Lakshay983/TrialWorkday-PCB/BPS-Amperes.kicad_sch

## KiCad design BPS-Amperes.kicad_sch (2024-09-21)

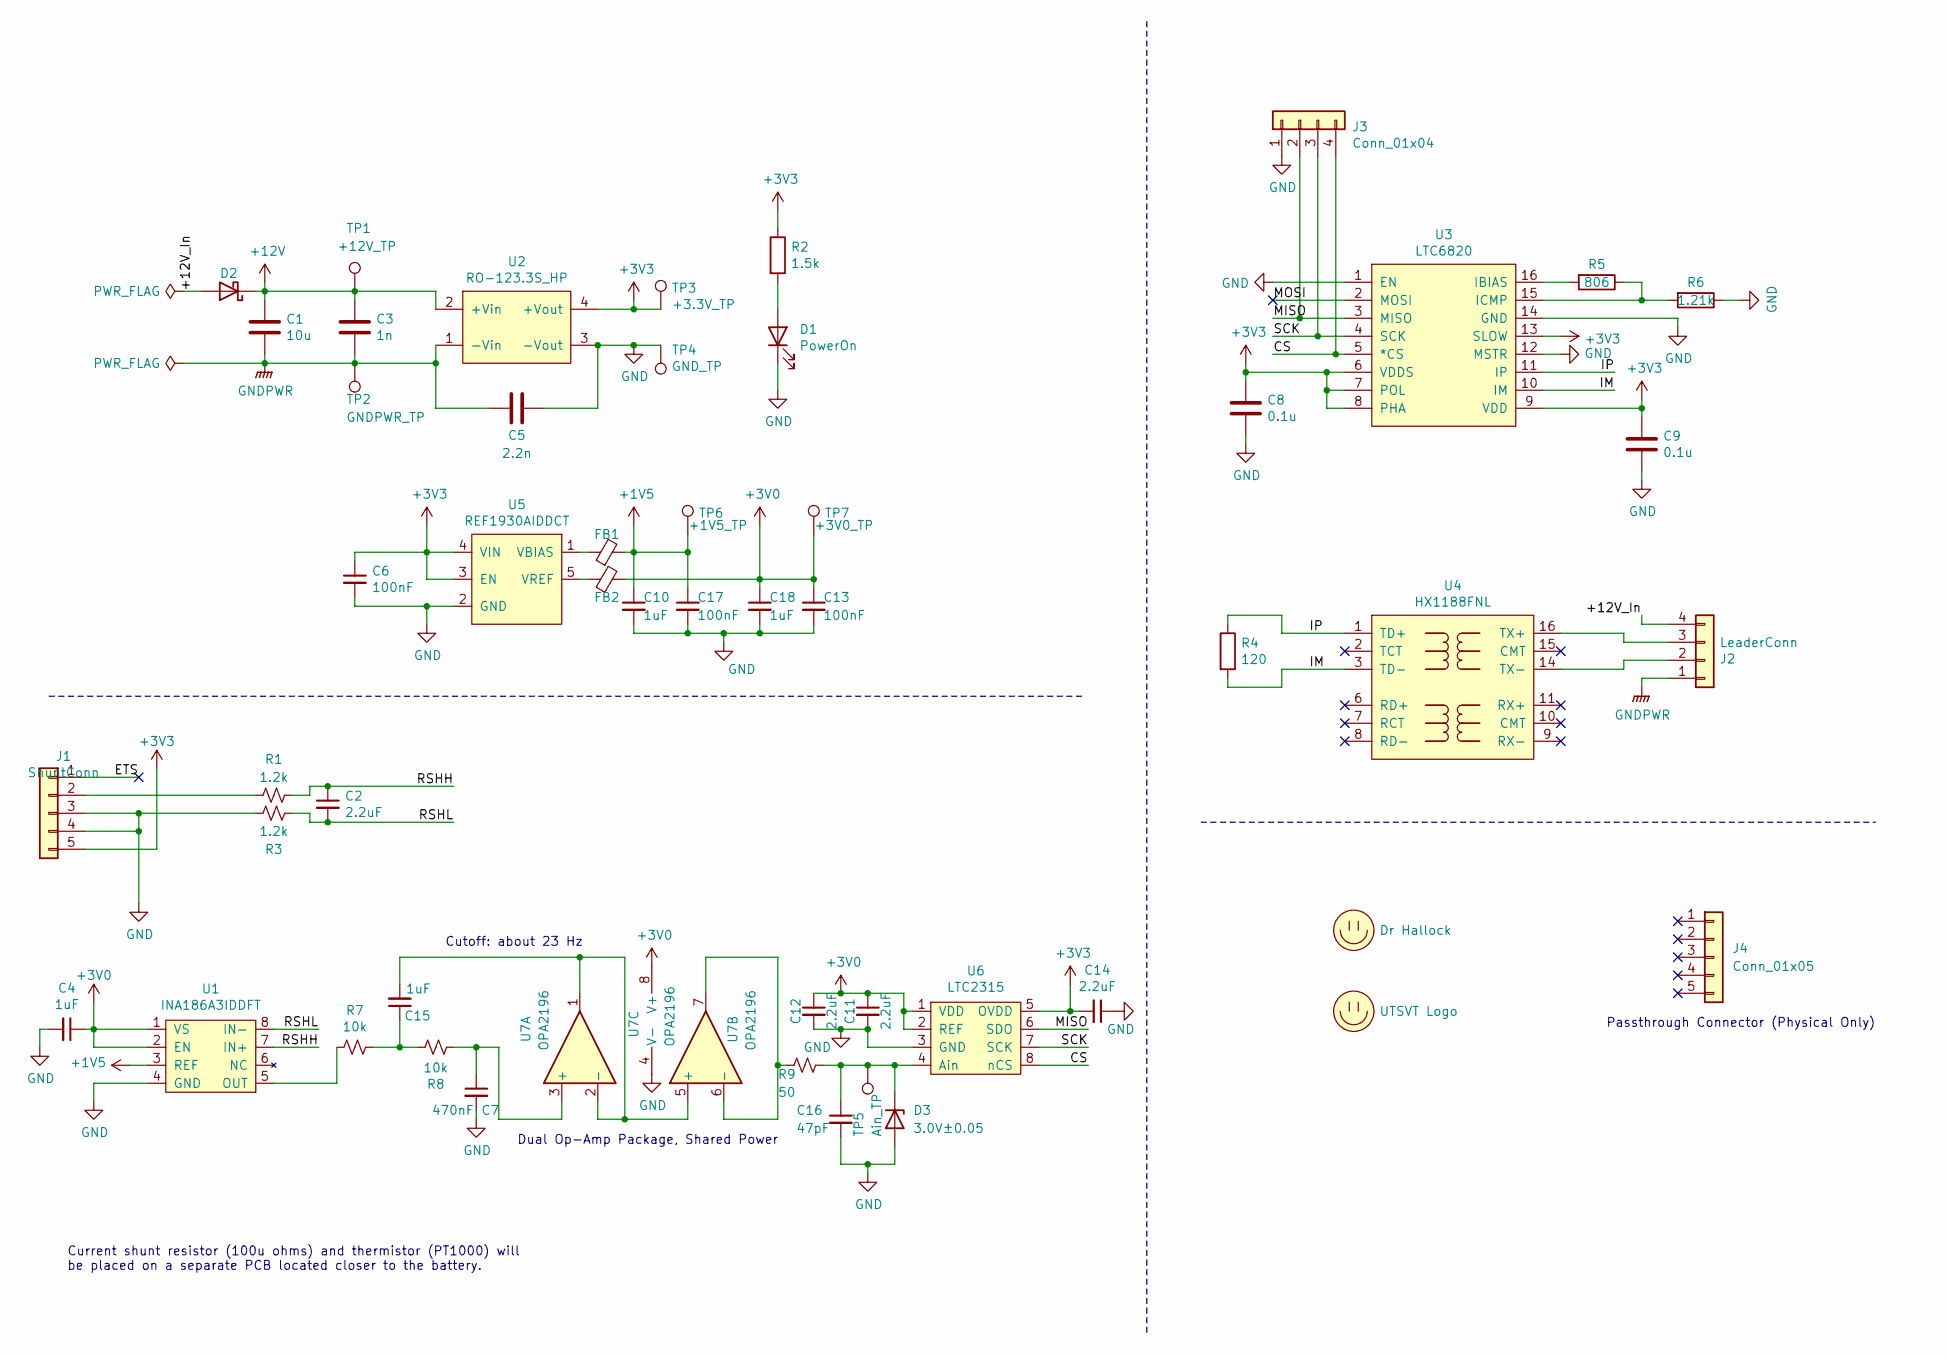
[picture p1: schematic BPS-Amperes.kicad_sch]

Parts:
C1: 10u; C_2220_5750Metrix
C2, C11, C12, C14: 2.2uF; C_0805_2012Metric
C3: 1n; C_0805_2012Metric
C4, C10, C15, C18: 1uF; C_0805_2012Metric
C5: 2.2n; C_0805_2012Metric
C6, C13, C17: 100nF; C_0805_2012Metric
C7: 470nF; C_0805_2012Metric
C8, C9: 0.1u; C_0805_2012Metric
C16: 47pF; C_0805_2012Metric
D1: PowerOn; LED_0805_2012Metric
D2: D_Schottky; D_0805_2012Metric
D3: 3.0V±0.05; D_0805_2012Metric
FB1, FB2: FerriteBead_Small; L_0805_2012Metric
J1: ShuntConn; PinSocket_1x05_P2.54mm_Vertical
J2: LeaderConn; Molex_Micro-Fit_3.0_43650-0415_1x04_P3.00mm_Vertical
J3: Conn_01x04; PinHeader_1x04_P2.54mm_Vertical
J4: Conn_01x05; PinHeader_1x05_P2.54mm_Vertical
LOGO1: Dr Hallock; Hallock_Image_Tiny
LOGO2: UTSVT Logo; UTSVT_Logo_Symbol
R1, R3: 1.2k; R_0805_2012Metric
R2: 1.5k; R_0805_2012Metric
R4: 120; R_0805_2012Metric
R5: 806; R_0805_2012Metric
R6: 1.21k; R_0805_2012Metric
R7, R8: 10k; R_0805_2012Metric
R9: 50; R_0805_2012Metric
TP1: +12V_TP; TestPoint_Pad_2.0x2.0mm
TP2: GNDPWR_TP; TestPoint_Pad_2.0x2.0mm
TP3: +3.3V_TP; TestPoint_Pad_1.5x1.5mm
TP4: GND_TP; TestPoint_Pad_1.5x1.5mm
TP5: Ain_TP; PinSocket_1x01_P2.54mm_Vertical
TP6: +1V5_TP; TestPoint_Pad_1.5x1.5mm
TP7: +3V0_TP; TestPoint_Pad_1.5x1.5mm
U1: INA186A3IDDFT; SOT-23-8
U2: RO-123.3S_HP; RI3_DC_Converter
U3: LTC6820; MSOP-16_3x4mm_P0.5mm
U4: HX1188FNL; HXXXX
U5: REF1930AIDDCT; SOT-23-5
U6: LTC2315; SOT-23-8
U7: OPA2196; SOIC-8_3.9x4.9mm_P1.27mm

Connections:
+1V5: C10.1, C17.1, FB1.2, TP6.1, U1.3 (REF)
+3V0: C4.1, C11.1, C12.1, C13.1, C18.1, FB2.2, TP7.1, U1.1 (VS), U1.2 (EN), U6.1 (VDD), U6.2 (REF), U7.8 (V+)
+3V3: C6.1, C8.1, C9.1, C14.2, J1.5, R2.1, TP3.1, U2.4 (+Vout), U3.6 (VDDS), U3.7 (POL), U3.8 (PHA), U3.9 (VDD), U3.13 (SLOW), U5.3 (EN), U5.4 (VIN), U6.5 (OVDD)
+12V: C1.1, C3.1, D2.1 (K), TP1.1, U2.2 (+Vin)
+12V_In: D2.2 (A), J2.4
CS: J3.4, U3.5 (*CS), U6.8 (nCS)
ETS: J1.1
GND: C4.2, C5.2, C6.2, C7.2, C8.2, C9.2, C10.2, C11.2, C12.2, C13.2, C14.1, C16.2, C17.2, C18.2, D1.1 (K), D3.2 (A), J1.3, J1.4, J3.1, R3.2, R6.1, TP4.1, U1.4 (GND), U2.3 (-Vout), U3.1 (EN), U3.12 (MSTR), U3.14 (GND), U5.2 (GND), U6.3 (GND), U7.4 (V-)
GNDPWR: C1.2, C3.2, C5.1, J2.1, TP2.1, U2.1 (-Vin)
IM: R4.2, U3.10 (IM), U4.3 (TD-)
IP: R4.1, U3.11 (IP), U4.1 (TD+)
MISO: J3.2, U3.3 (MISO), U6.6 (SDO)
MOSI: U3.2 (MOSI)
unnamed: C7.1, R8.2, U7.3 (+)
unnamed: C15.1, R7.1, R8.1
unnamed: C15.2, U7.1, U7.2 (-), U7.5 (+)
unnamed: C16.1, D3.1 (K), R9.2, TP5.1, U6.4 (Ain)
unnamed: D1.2 (A), R2.2
unnamed: FB1.1, U5.1 (VBIAS)
unnamed: FB2.1, U5.5 (VREF)
unnamed: J1.2, R1.2
unnamed: J2.2, U4.14 (TX-)
unnamed: J2.3, U4.16 (TX+)
unnamed: R5.1, R6.2, U3.15 (ICMP)
unnamed: R5.2, U3.16 (IBIAS)
unnamed: R7.2, U1.5 (OUT)
unnamed: R9.1, U7.6 (-), U7.7
RSHH: C2.1, R1.1, U1.7 (IN+)
RSHL: C2.2, R3.1, U1.8 (IN-)
SCK: J3.3, U3.4 (SCK), U6.7 (SCK)

Notes on the sheet:
Current shunt resistor (100u ohms) and thermistor (PT1000) will be placed on a separate PCB located closer to the battery.
Cutoff: about 23 Hz
Passthrough Connector (Physical Only)
Dual Op-Amp Package, Shared Power
