Lakshay983/TrialWorkday-PCB/(commit log)

2021-08-29 fix merge conflict
    [BPS-Amperes.kicad_pcb]
2021-10-01 Replace AS8510 with AD8417+ADS7042
    [BPS-Amperes.kicad_pcb, BPS-Amperes.sch]
2021-10-02 Set up for new amplification scheme
    [BPS-Amperes.kicad_pcb, BPS-Amperes.sch]
2021-11-06 Revised with LTC ADC
    [BPS-Amperes.kicad_pcb, BPS-Amperes.sch]
2021-12-22 Add additional filtering
    [BPS-Amperes.kicad_pcb, BPS-Amperes.sch]
2021-12-24 Add voltage follower before ADC
    [BPS-Amperes.kicad_pcb, BPS-Amperes.sch]
2021-12-25 Space out components
    [BPS-Amperes.kicad_pcb]
2021-12-25 Minor change to capacitor value
    [BPS-Amperes.sch]
2021-12-25 Flip logo
    [BPS-Amperes.kicad_pcb]
2022-01-15 Update to what should be the final version
    [Amperes.step, BPS-Amperes.kicad_pcb, BPS-Amperes.kicad_sch, BPS-Amperes.sch]
2022-01-15 Minor fixing
    [BPS-Amperes.kicad_pcb, BPS-Amperes.kicad_sch]
2022-01-22 Update label
    [BPS-Amperes.kicad_pcb]
2022-09-24 emi + reverse polarity + analog overvolt protection
    [BPS-Amperes.kicad_sch]
2022-09-24 hat connector
    [BPS-Amperes.kicad_sch]
2022-10-08 more bypass caps and other fixes
    [BPS-Amperes.kicad_sch]
2022-10-08 make a little easier on the eyes
    [BPS-Amperes.kicad_sch]
2022-10-08 datasheets & annotations
    [BPS-Amperes.kicad_sch]
2022-10-08 shunt connector change
    [BPS-Amperes.kicad_sch]
2022-10-08 bom💣
    [BPS-Amperes.xlsx]
2022-10-09 mouser 🐁 bom 💣 cart 🛒
    [BPS-Amperes.csv, BPS-Amperes.kicad_sch, BPS-Amperes.xlsx]
2022-10-29 layout with no pours
    [BPS-Amperes.kicad_pcb, BPS-Amperes.kicad_sch]
2022-10-29 add 👈 pass 💦 through 🐲 connector
    and move 📦 things 🍄 around ➕🏜️➡️👤 a bit 😁
    [BPS-Amperes.kicad_pcb, BPS-Amperes.kicad_sch]
2022-10-31 tighten ground pour
    [BPS-Amperes.kicad_pcb]
2022-11-05 picket fence
    [BPS-Amperes.kicad_pcb, BPS-Amperes.kicad_sch]
2022-11-05 Fixed silkscreens
2022-11-15 Added silkscreens
    [BPS-Amperes.kicad_pcb]
2022-11-19 gerbers 🐹 and drills 🪛
    [BPS-Amperes-B_Cu.gbr, BPS-Amperes-B_Mask.gbr, BPS-Amperes-B_Paste.gbr, BPS-Amperes-B_Silkscreen.gbr, BPS-Amperes-Edge_Cuts.gbr, BPS-Amperes-F_Cu.gbr, BPS-Amperes-F_Mask.gbr, BPS-Amperes-F_Paste.gbr]
2022-11-20 we 👥 do 😳 a little ⌚ graphic designing
    [BPS-Amperes.kicad_pcb]
2023-01-21 fixed bom + ibom
    [BPS-Amperes.csv, BPS-Amperes.kicad_pcb, BPS-Amperes.kicad_sch, BPS-Amperes.xlsx]
2023-01-24 bom updates
    [BPS-Amperes.csv, BPS-Amperes.kicad_sch, BPS-Amperes.xlsx]
2024-09-21 womp womp
    [BPS-Amperes.kicad_pcb, BPS-Amperes.kicad_sch, BPS-Amperes.xlsx]
